lakshmi-sathi/avsdpll_1v8/Images/CaravelSoCTemplate.jpg

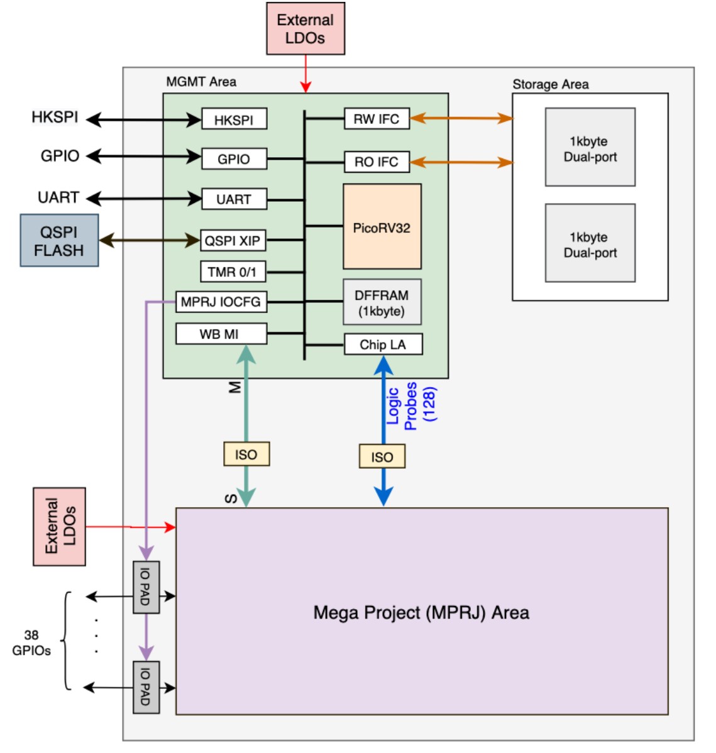
Images/CaravelSoCTemplate.jpg
