lakshmi-sathi/avsdpll_1v8/Images/net_trace.jpg

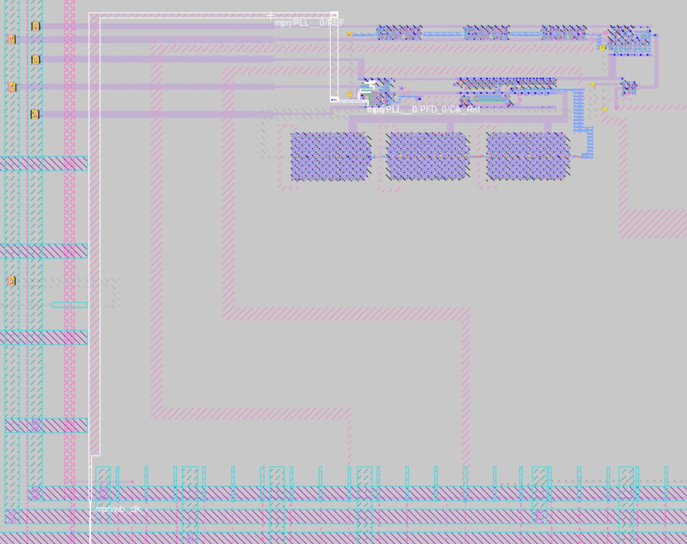
Images/net_trace.jpg
