lakshmi-sathi/avsdpll_1v8/Images/opening_magic.jpg

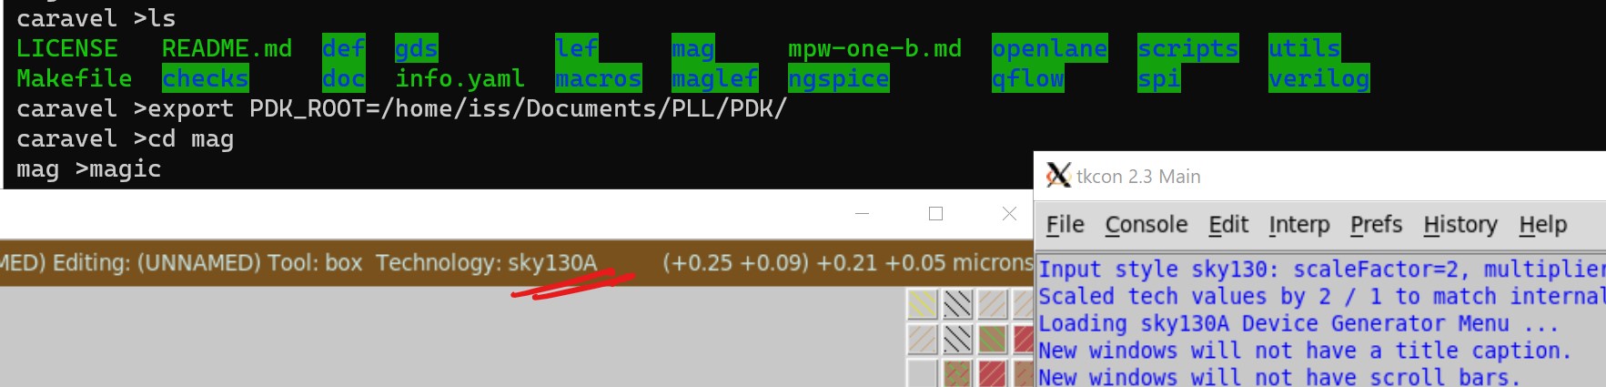
Images/opening_magic.jpg
