lakshmi-sathi/avsdpll_1v8/Images/place_ip.jpg

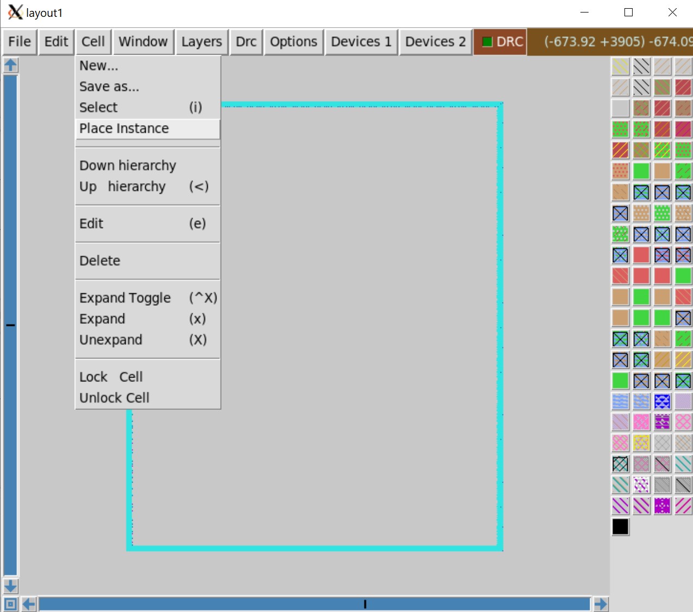
Images/place_ip.jpg
