lakshmi-sathi/avsdpll_1v8/Images/PLL_in_caravel.jpg

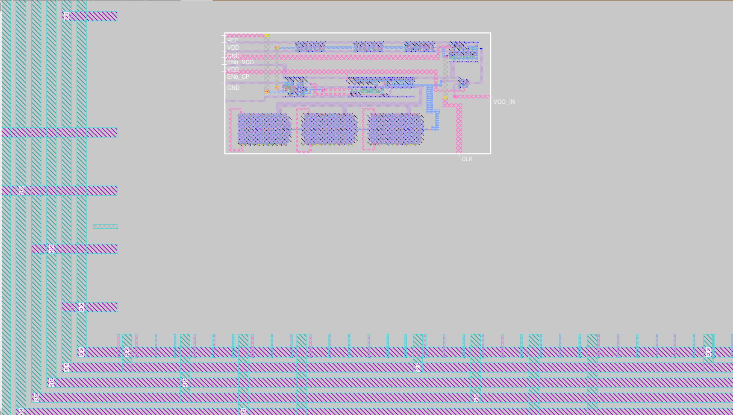
Images/PLL_in_caravel.jpg
