lakshmi-sathi/avsdpll_1v8/Images/selected.jpg

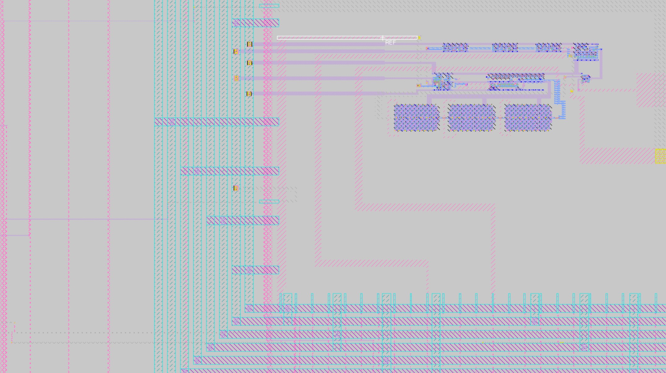
Images/selected.jpg
