lakshmi-sathi/avsdpll_1v8/PostLayout/Specs/PLL_drc_clean.jpg

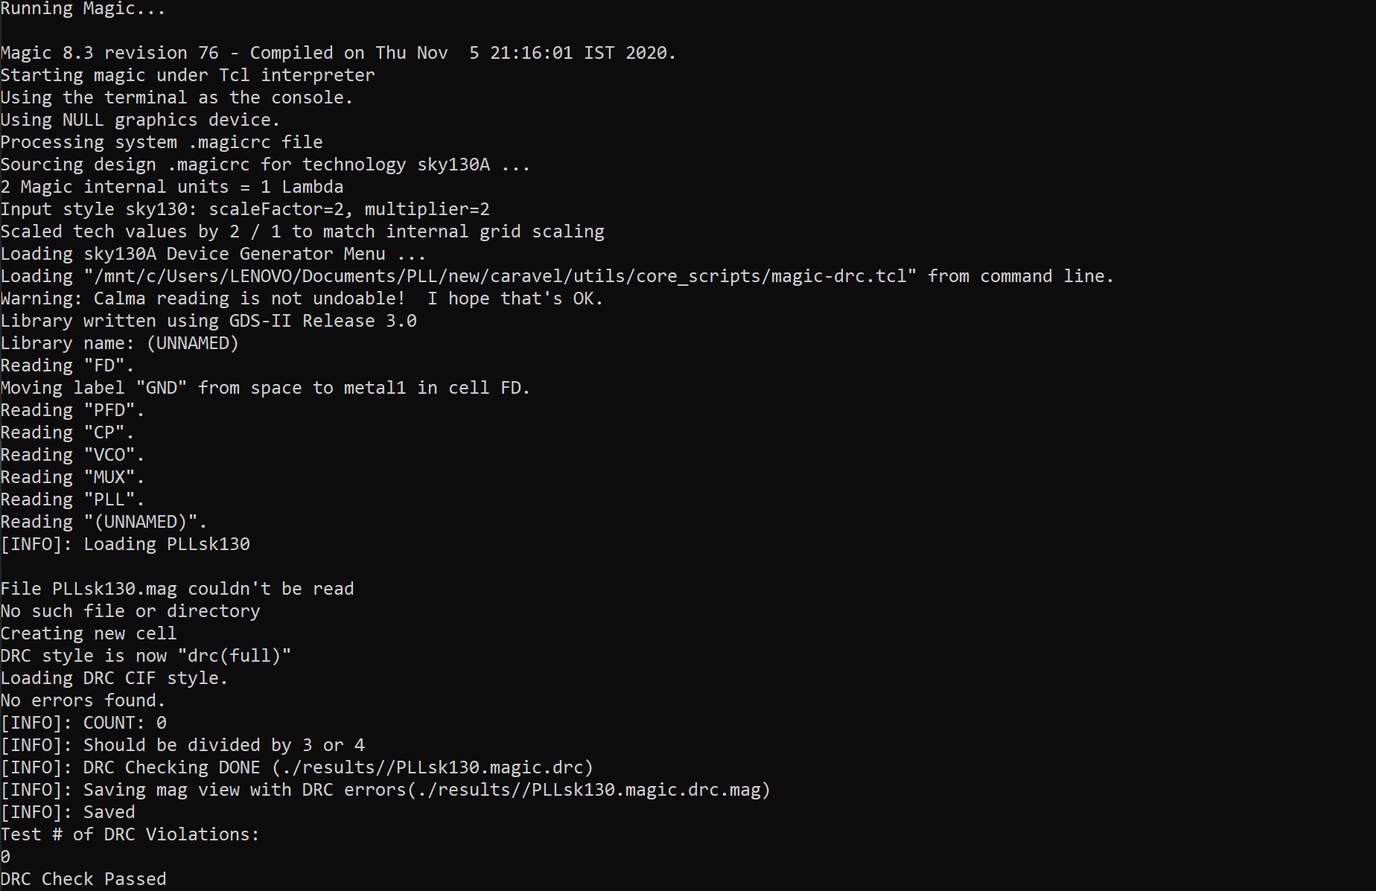
PostLayout/Specs/PLL_drc_clean.jpg
