lakshmi-sathi/avsdpll_1v8/PreLayout/CP.jpg

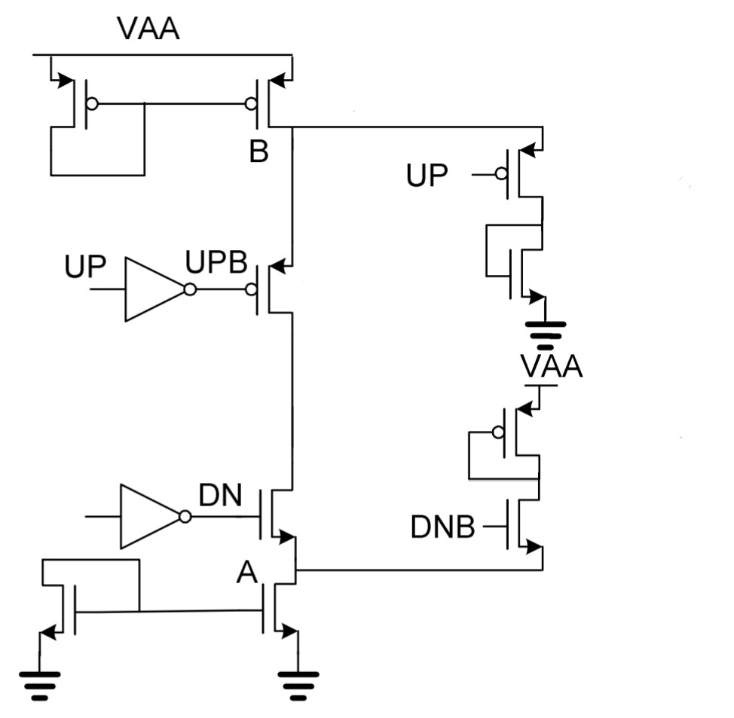
PreLayout/CP.jpg
