lakshmi-sathi/avsdpll_1v8/PreLayout/FD.jpg

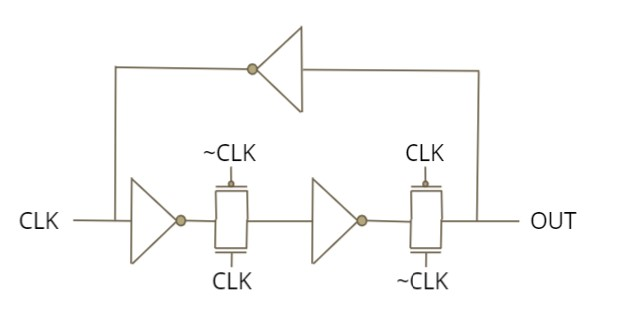
PreLayout/FD.jpg
