lakshmi-sathi/avsdpll_1v8/PreLayout/PFD.jpg

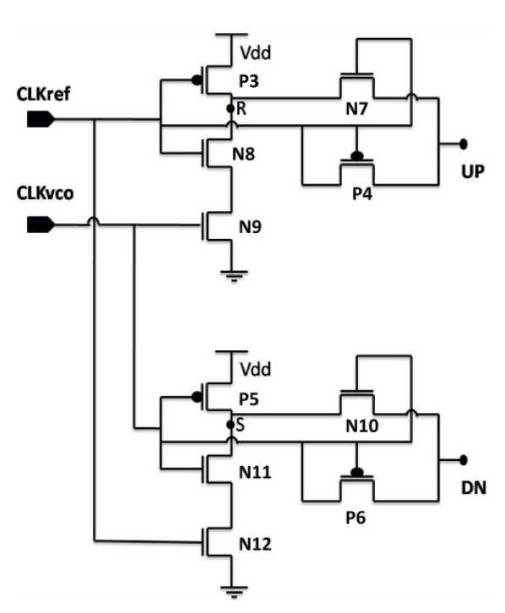
PreLayout/PFD.jpg
