lakshmi-sathi/avsdpll_1v8/PreLayout/VCO.jpg

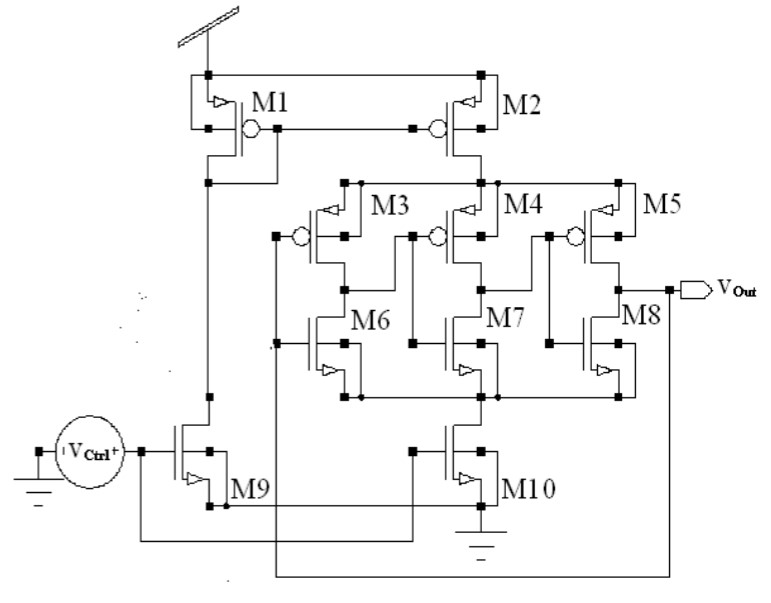
PreLayout/VCO.jpg
