lakshmi-sathi/avsdpll_1v8/PostLayout/Simulation_Results/VCO_PostLay_0v6.jpg

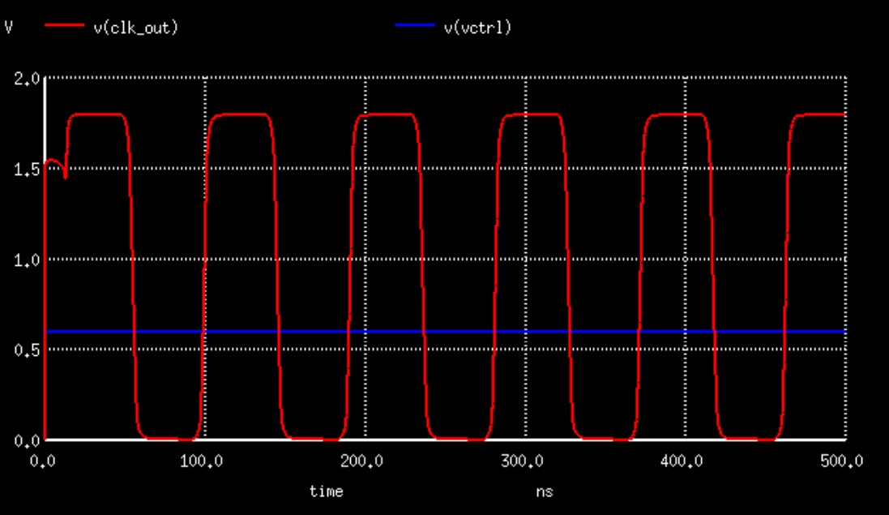
PostLayout/Simulation_Results/VCO_PostLay_0v6.jpg
