lakshmi-sathi/avsdpll_1v8/PreLayout/Simulation_Results/VCO_PreLay_0v6.jpg

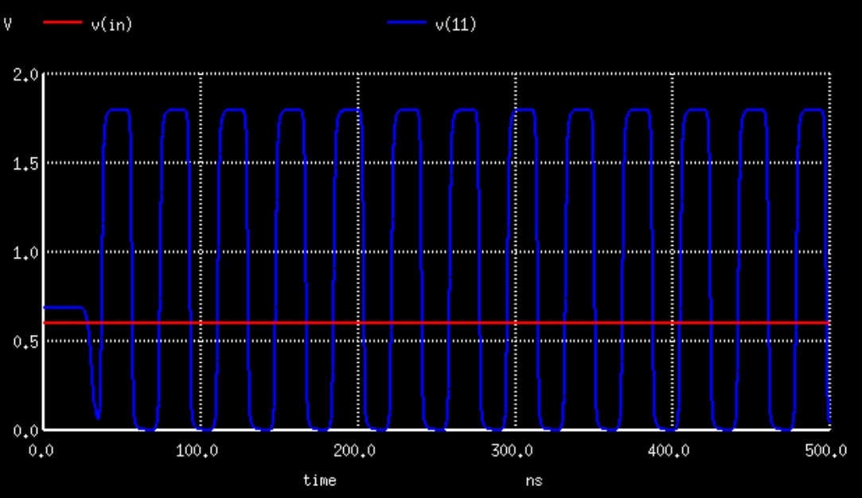
PreLayout/Simulation_Results/VCO_PreLay_0v6.jpg
