lakshmi-sathi/avsdpll_1v8/(commit log)

2020-10-30 Adding PLL circuit spice netlist
2020-10-31 PD and FD schematic Images
2020-10-31 adding FD schematic
2020-11-01 Create chpmp_sc.cir
    Charge Pump based on SC transistor for good current matching characteristics
2020-11-01 Adding chargepmp simulation images
2020-11-01 PLL netlist update, CP Schematic
2020-11-21 fixing sky130primitives
    [sky130_fd_pr__nfet_01v8.bins.csv, sky130_fd_pr__nfet_01v8_aM02W1p65L0p15.netlist.tsv, sky130_fd_pr__nfet_01v8_aM02W1p65L0p18.netlist.tsv, sky130_fd_pr__nfet_01v8_aM02W1p65L0p25.netlist.tsv, sky130_fd_pr__nfet_01v8_aM02W3p00L0p15.netlist.tsv, sky130_fd_pr__nfet_01v8_aM02W3p00L0p18.netlist.tsv, sky130_fd_pr__nfet_01v8_aM02W3p00L0p25.netlist.tsv, sky130_fd_pr__nfet_01v8_aM02W5p00L0p15.netlist.tsv]
2021-07-28 schematic diagrams and latest tech file
2021-07-30 edits for workshop
    [sky130_fd_pr__nfet_01v8.bins.csv, sky130_fd_pr__nfet_01v8_aM02W1p65L0p15.netlist.tsv, sky130_fd_pr__nfet_01v8_aM02W1p65L0p18.netlist.tsv, sky130_fd_pr__nfet_01v8_aM02W1p65L0p25.netlist.tsv, sky130_fd_pr__nfet_01v8_aM02W3p00L0p15.netlist.tsv, sky130_fd_pr__nfet_01v8_aM02W3p00L0p18.netlist.tsv, sky130_fd_pr__nfet_01v8_aM02W3p00L0p25.netlist.tsv, sky130_fd_pr__nfet_01v8_aM02W5p00L0p15.netlist.tsv]
